makersmakingchange/LipSync-Macro/README.md

## LipSync Macro

> [!IMPORTANT]
> **As of 2024-Feb-08, this version of the LipSync is now obsolete and has been replaced by the [LipSync 4](https://github.com/makersmakingchange/LipSync).**

The LipSync Macro is an assistive technology device that allows quadriplegics and other people with limited hand function to use touchscreen mobile devices, tablets, and computers by manipulation of a mouth-operated joystick with integrated sip and puff controls. This is an Open-Source Hardware project, so the Lipsync can be made at the community level for less than $300.

## Compatibility 

 <table style="width:100%">
  <tr>
    <th>Operating Systems</th>
    <th>Version</th>
    <th>Release</th>
    <th>Additional Information</th>
  <tr>
    <td>iOS</td>
    <td>7-12</td>
    <td>2014</td>
    <td>Compatible with iOS7-12 using Switch Control. For iOS13+ or iPadOS, see <i>LipSync</i> or <i>LipSync Wireless</i></td>
  </tr>
  <tr>
    <td>Android</td>
    <td>5+</td>
    <td>2014</td>
    <td>Requires enabling Switch Access or Universal Switch accessibility feature.</td>
  </tr>
 </table> 

## Download

 <table style="width:100%">
  <tr>
    <th>Resource</th>
    <th>Version</th>
    <th>Format</th>
    <th>Link</th>
  </tr>
    <tr>
    <td>LipSync Macro All</td>
    <td>3.0</td>
    <td>ZIP</td>
    <td><a href="https://github.com/makersmakingchange/LipSync-Macro/archive/refs/heads/main.zip">LipSync-Macro.zip</a></td>
  </tr>
  <tr>
    <td>LipSync Assembly Guide</td>
    <td>1.6</td>
    <td>PDF</td>
    <td><a href="https://github.com/makersmakingchange/LipSync-Macro/blob/main/Documentation/LipSync_Assembly_Guide.pdf">LipSync_Assembly_Guide.pdf</a></td>
  </tr>
  <tr>
    <td>LipSync Macro Startup Guide</td>
    <td>1.2</td>
    <td>PDF</td>
    <td><a href="https://github.com/makersmakingchange/LipSync-Macro/blob/main/Documentation/LipSync_Macro_Startup_Guide.pdf">LipSync_Macro_Startup_Guide.pdf</a></td>
  </tr>
  <tr>
    <td>LipSync Macro User Guide</td>
    <td>1.2</td>
    <td>PDF</td>
    <td><a href="https://github.com/makersmakingchange/LipSync-Macro/blob/main/Documentation/LipSync_Macro_User_Guide.pdf">LipSync_Macro_User_Guide.pdf</a></td>
  </tr>
  <tr>
     <td>LipSync Mounting Guide</td>
     <td>1.0</td>
     <td>PDF</td>
     <td><a href="https://github.com/makersmakingchange/LipSync-Macro/blob/main/Documentation/LipSync_Mounting_Guide.pdf">LipSync_Mounting_Guide.pdf</a></td>
  </tr>
  <tr>
    <td>LipSync Macro BOM (XLSX)</td>
    <td>September 1, 2021</td>
    <td>XLSX</td>
    <td><a href="https://github.com/makersmakingchange/LipSync-Macro/blob/main/Documentation/LipSync_Macro_BOM.xlsx">LipSync_Macro_BOM.xlsx</a></td>
  </tr>
  <tr>
    <td>LipSync Macro BOM (CSV)</td>
    <td>September 1, 2021</td>
    <td>CSV</td>
    <td><a href="https://github.com/makersmakingchange/LipSync-Macro/blob/main/Documentation/LipSync_Macro_BOM.csv">LipSync_Macro_BOM.csv</a></td>
  </tr>
  <tr>
    <td>LipSync Macro Firmware</td>
    <td>3.0</td>
    <td>INO</td>
    <td><a href="https://raw.githubusercontent.com/makersmakingchange/LipSync-Macro/main/Software/LipSync_Macro_Firmware/LipSync_Macro_Firmware.ino">LipSync_Macro_Firmware.ino</a></td>
  </tr>
  <tr>
    <td>LipSync Macro Interface Board Layout</td>
    <td>2.71</td>
    <td>BRD</td>
    <td><a href="https://raw.githubusercontent.com/makersmakingchange/LipSync-Macro/main/Hardware/PCB_design/Eagle/LipSync_Interface_Board/LipSync_Interface_Board.brd">LipSync_Interface_Board.brd</a></td>
  </tr>
  <tr>
    <td>LipSync Macro Interface Board Schematic</td>
    <td>2.71</td>
    <td>SCH</td>
    <td><a href="https://raw.githubusercontent.com/makersmakingchange/LipSync-Macro/main/Hardware/PCB_design/Eagle/LipSync_Interface_Board/LipSync_Interface_Board.sch">LipSync_Interface_Board.sch</a></td>
  </tr>
  <tr>
    <td>JLCPCB LipSync Macro Interface Board Gerber</td>
    <td>2.71</td>
    <td>ZIP</td>
    <td><a href="https://github.com/makersmakingchange/LipSync-Macro/raw/main/Hardware/PCB_design/Gerber/LipSync_Interface_Board/JLCPCB_LipSync_Interface_Board.zip">JLCPCB_LipSync_Interface_Board.zip</a></td>
  </tr>
  <tr>
    <td>OSHPark LipSync Macro Interface Board Gerber</td>
    <td>2.71</td>
    <td>ZIP</td>
    <td><a href="https://github.com/makersmakingchange/LipSync-Macro/raw/main/Hardware/PCB_design/Gerber/LipSync_Interface_Board/OSHPark_LipSync_Interface_Board.zip">OSHPark_LipSync_Interface_Board.zip</a></td>
  </tr>
  <tr>
    <td>PCBWay LipSync Macro Interface Board Gerber</td>
    <td>2.71</td>
    <td>ZIP</td>
    <td><a href="https://github.com/makersmakingchange/LipSync-Macro/raw/main/Hardware/PCB_design/Gerber/LipSync_Interface_Board/PCBWay_LipSync_Interface_Board.zip">PCBWay_LipSync_Interface_Board.zip</a></td>
  </tr>
  <tr>
    <td>Seeed Fusion LipSync Macro Interface Board Gerber</td>
    <td>2.71</td>
    <td>ZIP</td>
    <td><a href="https://github.com/makersmakingchange/LipSync-Macro/raw/main/Hardware/PCB_design/Gerber/LipSync_Interface_Board/Seeed_Fusion_LipSync_Interface_Board.zip">Seeed_Fusion_LipSync_Interface_Board.zip</a></td>
  </tr>
  <tr>
    <td rowspan="9">Housing_design</td>
    <td rowspan="9">3.0</td>
    <td rowspan="9">STL</td>
    <td><a href="https://github.com/makersmakingchange/LipSync-Macro/blob/main/Hardware/Housing_design/LipSync_Button.stl">LipSync_Button.STL</a></td>
  </tr>
  <tr>
  <td><a href="https://github.com/makersmakingchange/LipSync-Macro/blob/main/Hardware/Housing_design/LipSync_Front_Housing.STL">LipSync_Front_Housing.STL</a></td>
  </tr>
  <tr>
  <td><a href="https://github.com/makersmakingchange/LipSync-Macro/blob/main/Hardware/Housing_design/LipSync_Joystick_Base.STL">LipSync_Joystick_Base.STL</a></td>
</tr>
<tr>
  <td><a href="https://github.com/makersmakingchange/LipSync-Macro/blob/main/Hardware/Housing_design/LipSync_Joystick_Front.STL">LipSync_Joystick_Front.STL</a></td>
</tr>
<tr>
  <td><a href="https://github.com/makersmakingchange/LipSync-Macro/blob/main/Hardware/Housing_design/LipSync_Joystick_Rocker.STL">LipSync_Joystick_Rocker.STL</a></td>
</tr>
<tr>
    <td><a href="https://github.com/makersmakingchange/LipSync-Macro/blob/main/Hardware/Housing_design/Optional/LipSync_Joystick_Jig.STL">LipSync_Joystick_Jig.STL</a></td>
</tr>
<tr>
  <td><a href="https://github.com/makersmakingchange/LipSync-Macro/blob/main/Hardware/Housing_design/LipSync_Rear_Housing.STL">LipSync_Rear_Housing.STL</a></td>
</tr>
<tr>
  <td><a href="https://github.com/makersmakingchange/LipSync-Macro/blob/main/Hardware/Housing_design/3D_Print_Settings.txt">3D_Print_Settings.txt</a></td>
</tr>
</table> 

## Resources

<table style="width:100%">
  <tr>
    <th>Resource</th>
    <th>Link</th>
  </tr>
  <tr>
    <td>LipSync Firmware and Calibration Video</td>
    <td><a href="https://www.youtube.com/watch?v=RnpA24WH0Qk">Video</a></td>
  <tr>
    <td>LipSync Joystick Calibration Video</td>
    <td><a href="https://www.youtube.com/watch?v=Daf-54y6SBg">Video</a></td>
  </tr>
    <tr>
    <td>LipSync Build Video</td>
    <td><a href="https://www.youtube.com/watch?v=lBXpbkp5DW4&list=PLhoPg9bDvBR4CSFRfNbQ87ALnfaHOyM3C">Video</a></td>
  </tr>
</table> 

## License
Copyright (c) 2020-2024 Neil Squire / Makers Making Change.

This repository describes Open Hardware:
 - Everything needed or used to design, make, test, or prepare the LipSync Macro is licensed under the [CERN 2.0 Weakly Reciprocal license (CERN-OHL-W v2) or later](https://cern.ch/cern-ohl ) .
 - All software is under the [GNU General Public License v3.0 (GPL-3.0)](https://www.gnu.org/licenses/gpl.html).
 - Accompanying material such as instruction manuals, videos, and other copyrightable works that are useful but not necessary to design, make, test, or prepare the LipSync are published under a [Creative Commons Attribution-ShareAlike 4.0 license (CC BY-SA 4.0)](https://creativecommons.org/licenses/by-sa/4.0/) .

You may redistribute and modify this documentation and make products using it under the terms of the [CERN-OHL-W v2](https://cern.ch/cern-ohl).
This documentation is distributed WITHOUT ANY EXPRESS OR IMPLIED WARRANTY, INCLUDING OF MERCHANTABILITY, SATISFACTORY QUALITY AND FITNESS FOR A PARTICULAR PURPOSE.
Please see the CERN-OHL-W v2 for applicable conditions.

Source Location: https://github.com/makersmakingchange/LipSync-Macro

## Attribution

The LipSync-Macro was designed by Neil Squire Society / Makers Making Change. The initial development of a 3D printable LipSync was supported by the Google Impact Challenge: Disabilities grant from Google.org. Further development was supported through the Government of Canada's Innovation Science and Economic Development Assistive Technology Program. These and other funders have also enabled Neil Squire / Makers Making Change to deploy numerous LipSyncs to users at reduced cost.

The LipSync firmware utilizes the Arduino development platform, an open-source electronics platform based on easy-to-use hardware and software. Arduino is developed and maintained by the Arduino community, and the project wouldn't be possible without their contributions.
Arduino is a registered trademark of Arduino AG. For more information about Arduino and to contribute to the community, visit the official Arduino website at www.arduino.cc.

### Contributors
 - Milad Hajihassan, Neil Squire Society / Makers Making Change.

----

<!-- ABOUT MMC START -->
## About Makers Making Change
[Makers Making Change Logo](https://www.makersmakingchange.com/)

Makers Making Change is a program of [Neil Squire](https://www.neilsquire.ca/), a Canadian non-profit that uses technology, knowledge, and passion to empower people with disabilities.

Makers Making Change leverages the capacity of community based Makers, Disability Professionals and Volunteers to develop and deliver affordable Open Source Assistive Technologies.

 - Website: [www.MakersMakingChange.com](https://www.makersmakingchange.com/)
 - GitHub: [makersmakingchange](https://github.com/makersmakingchange)
 - Bluesky: [@makersmakingchange.bsky.social](https://bsky.app/profile/makersmakingchange.bsky.social)
 - Instagram: [@makersmakingchange](https://www.instagram.com/makersmakingchange)
 - Facebook: [makersmakechange](https://www.facebook.com/makersmakechange)
 - LinkedIn: [Neil Squire Society](https://www.linkedin.com/company/neil-squire-society/)
 - Thingiverse: [makersmakingchange](https://www.thingiverse.com/makersmakingchange/about)
 - Printables: [MakersMakingChange](https://www.printables.com/@MakersMakingChange)

### Contact Us
For technical questions, to get involved, or to share your experience we encourage you to [visit our website](https://www.makersmakingchange.com/) or [contact us](https://www.makersmakingchange.com/s/contact).
<!-- ABOUT MMC END -->
