makersmakingchange/LipSync-Macro/Hardware/Housing_design/Optional/LipSync_Joystick_Jig.STL

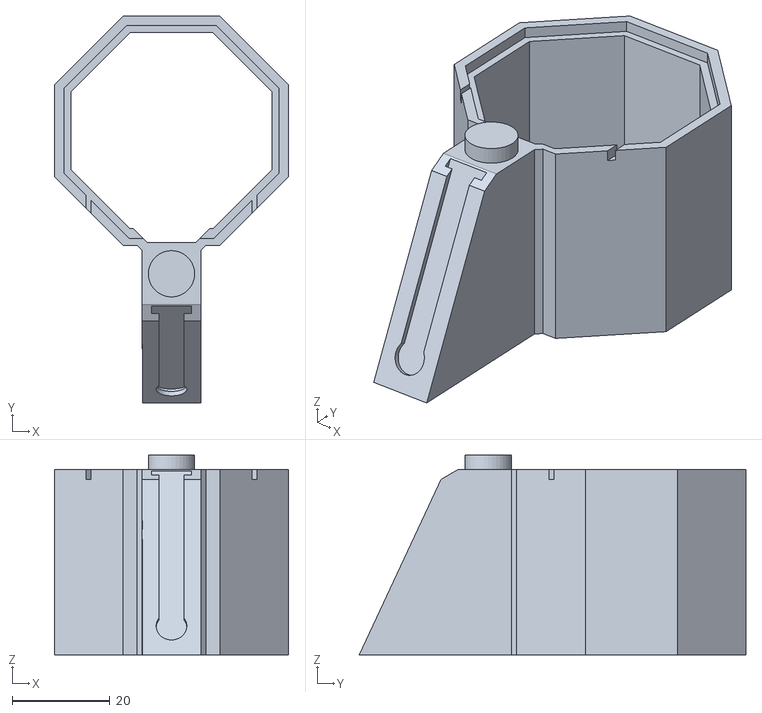
[picture p3: CAD file, 2019-09-17]
Hardware/Housing_design/Optional/LipSync_Joystick_Jig.STL
48.0 x 79.3 x 41.0
