makersmakingchange/LipSync-Macro/Hardware/Housing_design/LipSync_Joystick_Base.STL

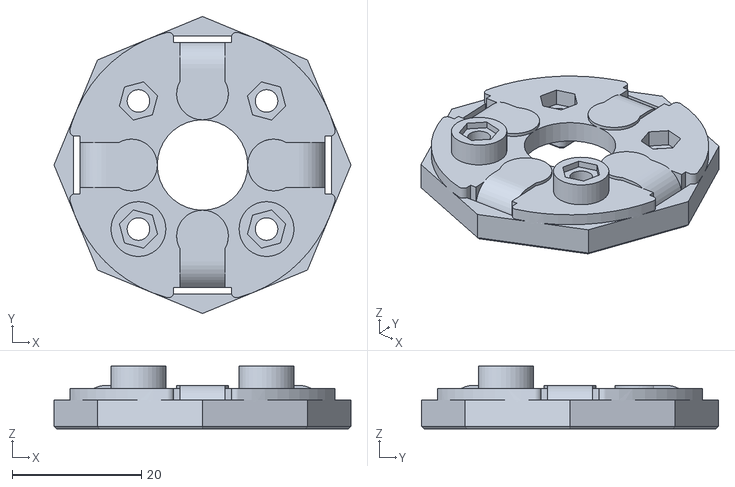
[picture p7: CAD file, 2019-09-17]
Hardware/Housing_design/LipSync_Joystick_Base.STL
46.0 x 46.0 x 9.75
