makersmakingchange/LipSync-Macro/(commit log)

2019-09-17 Added LipSync Macro Files
    [LipSync_Button.STL, LipSync_Front_Housing.STL, LipSync_Interface_Board.brd, LipSync_Interface_Board.sch, LipSync_Joystick_Base.STL, LipSync_Joystick_Front.STL, LipSync_Joystick_Rocker.STL, LipSync_Joystick_Stand.STL]
2019-09-20 Added the updated LipSync Manual, LipSync Macro User Guide, LipSync Macro Startup Guide, and LipSync Macro BOM File.
    [LipSync_Macro_BOM.csv, LipSync_Macro_BOM.xlsx]
2019-09-20 Added the updated LipSync Manual, LipSync User Guide, LipSync Startup Guide, and LipSync BOM File.
2019-10-01 Update to V2.3
    - The shell is slightly longer and the rear portion is slightly wider to accommodate a greater range of USB cables. The cut-out near the mounting hole is also larger and longer to prevent the threaded insert from damaging the cable, and allowing thicker cables to pass freely.
    - A recess has been added to the bottom to provide a less conspicuous location to apply any labelling.
    - The rear portion of the shell is larger and has greater surface area which should help mitigate any bed adhesion issues.
    - The cylindrical portions that house the springs have been lengthened and a catch was added that should retain the springs once they are pressed in. These changes should help m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
    [LipSync_Button.STL]
2019-10-01 Added PCB files Version 2.71 with updated MMC Logo.
    [LipSync_Interface_Board.brd, LipSync_Interface_Board.sch]
2019-10-01 Updated PCB version number in readme file.
2020-03-09 Added the updated LipSync Manual, LipSync Macro User Guide, LipSync Macro Setup Guide, and LipSync BOM File.
2020-04-15 Added PCB board gerber files.
    [LipSync_Interface_Board.brd, LipSync_Interface_Board.sch, LipSync_Joystick_Board.brd, LipSync_Joystick_Board.sch, LipSync_Main_Board.brd, LipSync_Main_Board.sch, LipSync_Pressure_Board.brd, LipSync_Pressure_Board.sch]
2020-04-15 Updated readme file
    Added the links to PCB board gerber files.
2020-05-08 Added the PCB Fabrication Manual
2020-08-10 Added change tolerance for each FSR
    [LipSync_Macro_Firmware.ino]
2020-11-25 Resolved EEPROM Debug and raw Mode status bug.
    [LipSync_Macro_Firmware.ino]
2022-06-16 Updated documents
    [LipSync_Macro_BOM.csv, LipSync_Macro_BOM.xlsx]
2022-06-17 Fixed sensitivity range bug
    [LipSync_Macro_Firmware.ino]
2022-06-17 Updated STL files to the latest version
    [LipSync_Front_Housing.STL, LipSync_Joystick_Jig.STL, LipSync_Rear_Housing.STL, LipSync_Rear_Housing.stl]
2022-07-18 Updated Rear Housing STL file
    [LipSync_Rear_Housing.stl]
2022-07-18 Updated readme information
    [LipSync_Button.STL]
2022-07-18 Added back Button STL file
    [LipSync_Button.stl]
